bdharrison/wireless-dcc/Decoder/DCC-Decoder.png

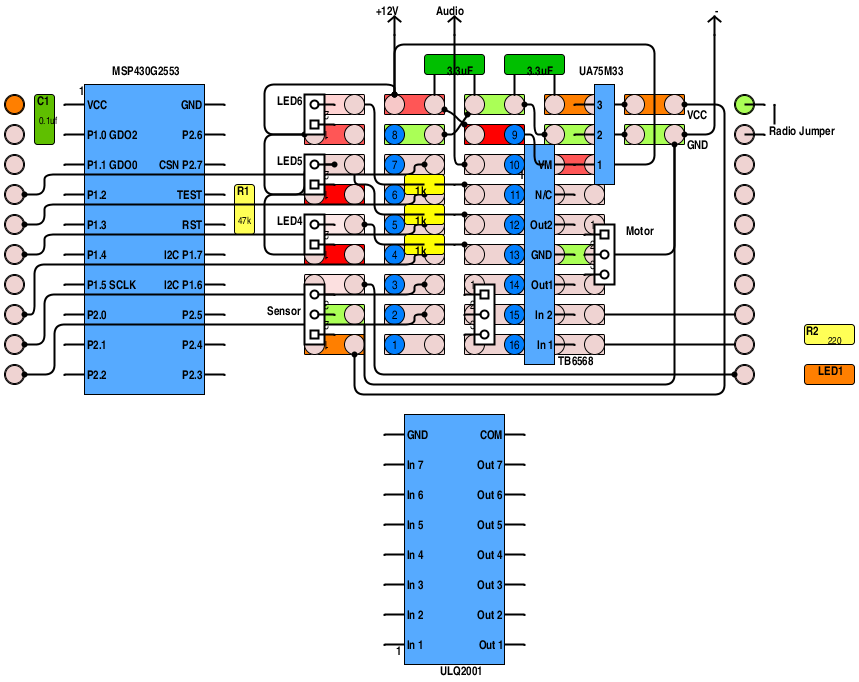
Decoder/DCC-Decoder.png
