bdharrison/wireless-dcc/Receiver/DCC-Receiver Layout.png

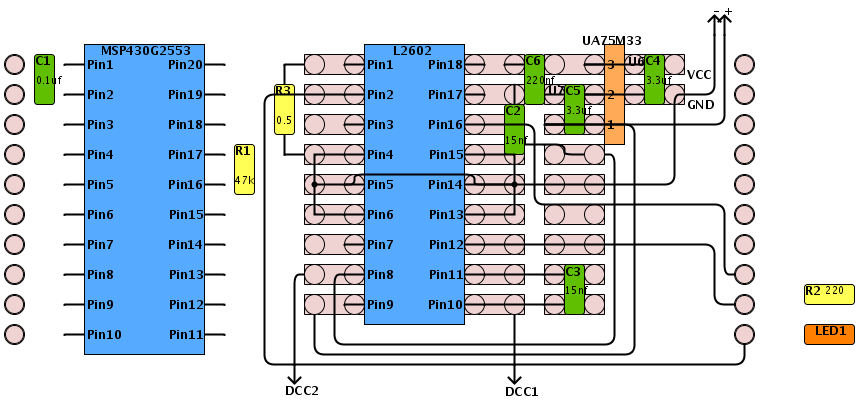
Receiver/DCC-Receiver Layout.png
