bdharrison/wireless-dcc/Receiver/DCC-Receiver Schematic.png

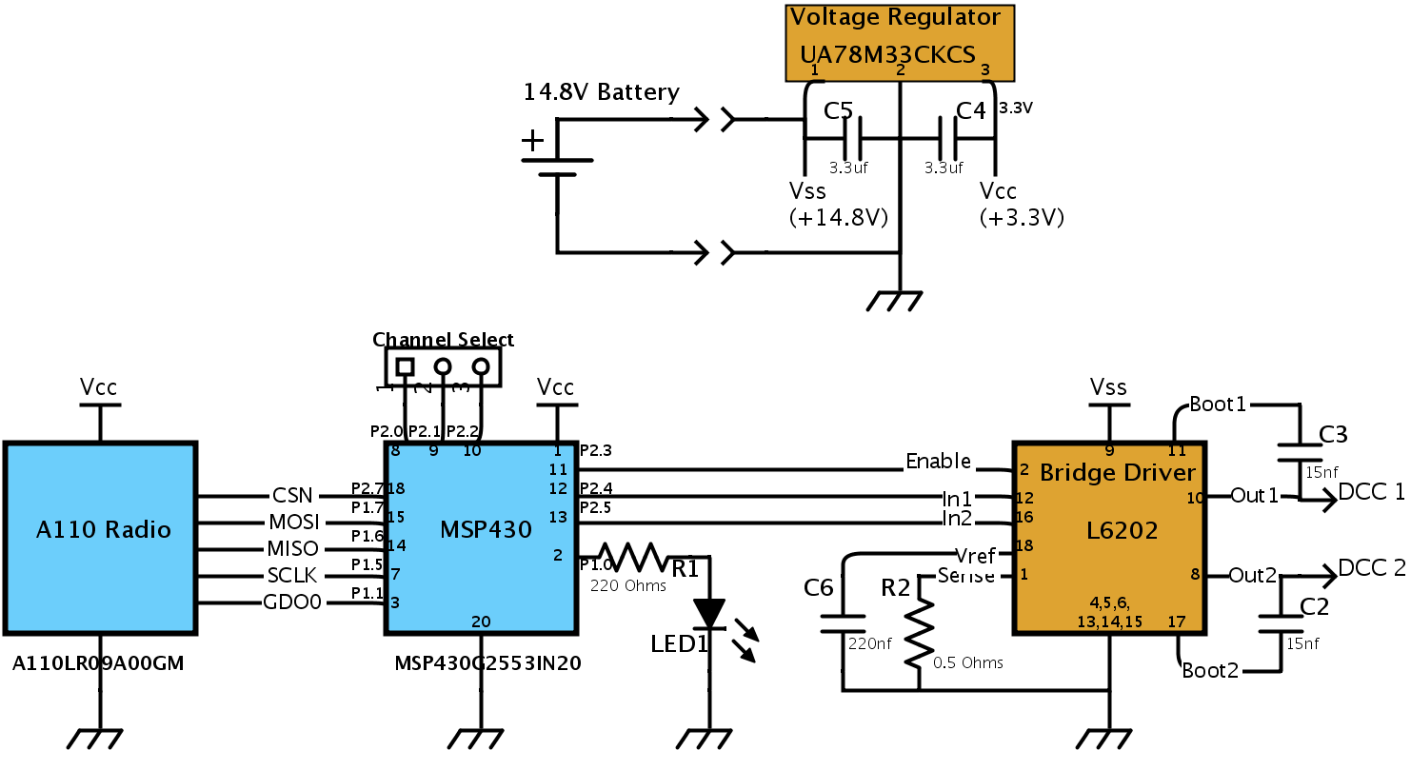
Receiver/DCC-Receiver Schematic.png
