bdharrison/wireless-dcc/Transmitter/Pushbutton Labels.png

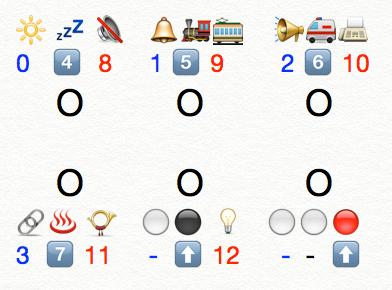
Transmitter/Pushbutton Labels.png
