bdharrison/wireless-dcc/WebController/HTML/ScreenShot.PNG

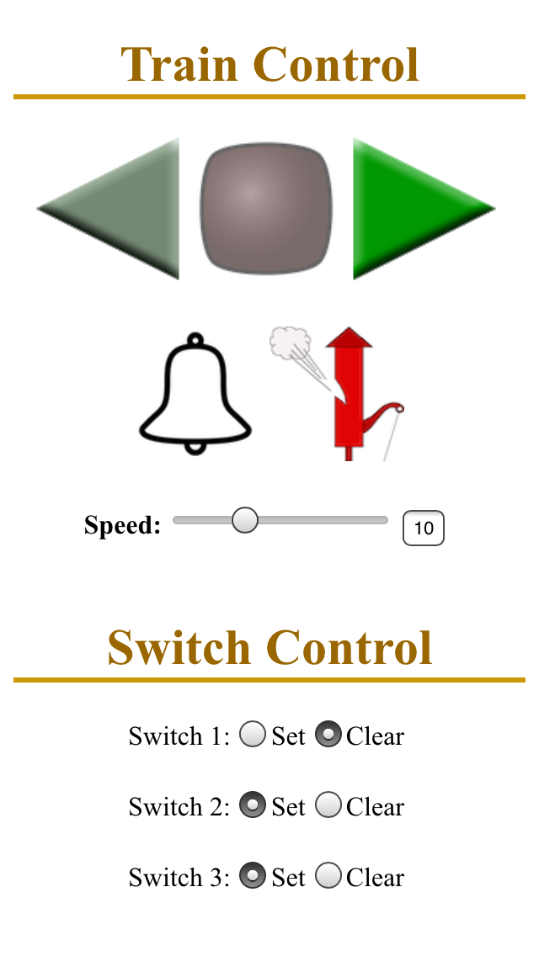
WebController/HTML/ScreenShot.PNG
