bdharrison/wireless-dcc/Receiver/DCC-Receiver Wiring.png

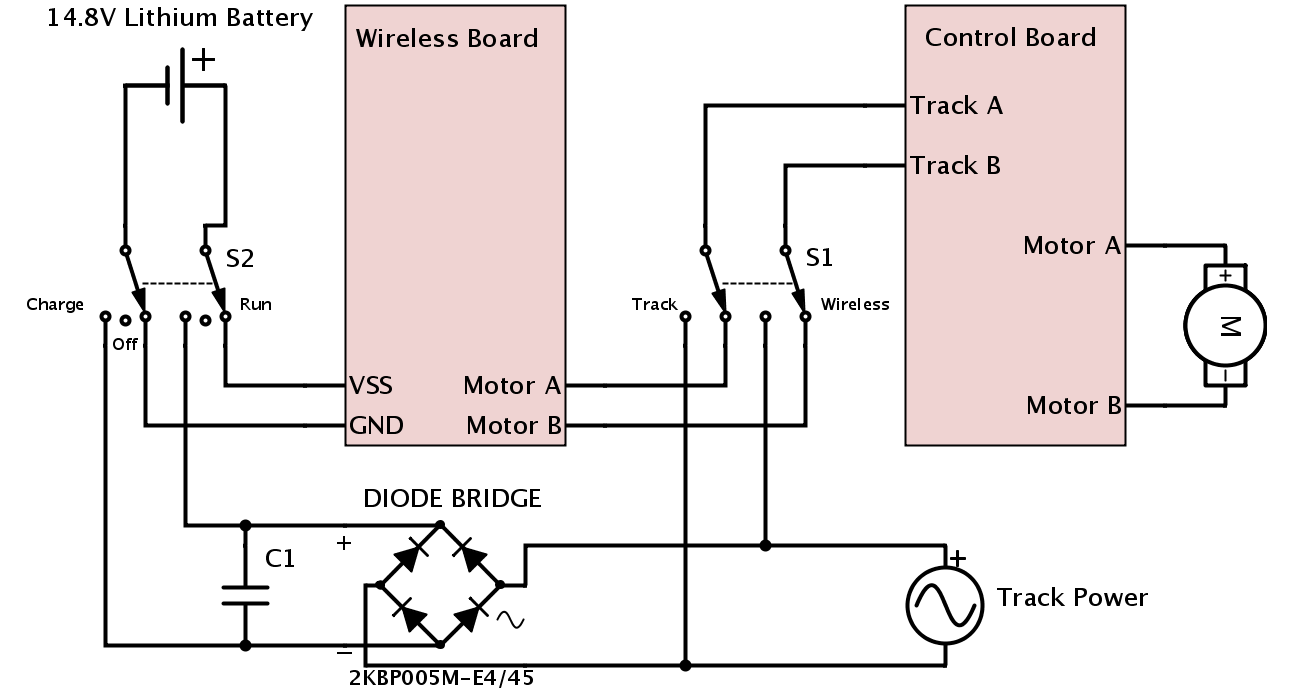
Receiver/DCC-Receiver Wiring.png
