bdharrison/wireless-dcc/(threads)

Thread 1 (2015-09-16):

issues changing channels

mdwildcat04, 2015-09-16:
built a transmitter and receiver, (actually, built them as in the GR articles, then modified them.)
these settings, they would not connect:
Tx
@1040
09 00 08 01 00 00 00 01 01 00 00 01 01 00 01 01
RX
@1040
09 00 08 04 00 01 02 FF 05 06 08 09 0C

but these settings work great.
Tx
@1040
09 00 05 01 00 00 00 01 01 00 00 01 01 00 01 01
RX
@1040
09 00 05 04 00 01 02 FF 05 06 08 09 0C

mdwildcat04, 2015-09-27:
I read the notes in the software, and realized that only 0-7 are supported.  I tried other channels and they all work, except 0.

bdharrison, 2015-11-09:
Sorry for delay in response, but I've been traveling and not monitoring this project.  Both the decoder and transmitter had a defect that didn't work with radio channel 0; now fixed by initializing 'current channel' to 0xff instead of 0.

mdwildcat04, 2016-01-26:
I noticed the change in the source files, and that the pinout changed, but the compiled hex files are unchanged.  Can I ask you to compile the new source?

bdharrison, 2016-01-30:
Sorry, forgot the hex files.  I've uploaded them now, let me know if there are any problems.

mdwildcat04, 2016-02-07:
I am still seeing the old ones on here....

bdharrison, 2016-02-08:
Can you try re-syncing?  I can see the updates as posted 10 days ago.
Decoder/Decoder.hex and Receiver/Receiver.hex.  You might need to click on
the 'branch' dropdown to force a re-sync to Master.
Cheers,
Brian.

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

mdwildcat04, 2016-02-10:
OK, I see the new hex file now.  that's weird
I have a board with this firmware on it.  the lights are working as expected, but it looks like the outputs for the bell and wisle are inverted.  I measure vdo at the pins normally, and 0 volts when the button is pressed.

mdwildcat04, 2016-02-10:
Never mind, after playing around with it some more, I went directly from the chip to the sound card, bypassing any buffer chip, and sound works as expected.

Thank you, this is working GREAT!!!!

bdharrison, 2016-02-10:
Thanks. Let me know if you've any suggestions for improvements. I'm
currently working on a version that connects to the Internet to allow
control via smartphone.
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

mdwildcat04, 2016-03-04:
will do.
What were you planning?   I had thought bout combining the radio with a Raspberry Pi and a small LCD to make a controller that allowed you to select engines, set up consists, ect with a graphical user interface.  Sadly, i cannot code my way out of a paper bag.......
Ideally, I would like to see a Wifi to air wire gateway.  something that would allow multiple users at the same time.

bdharrison, 2016-03-12:
I've created a version of the transmitter that accepts commands from a serial port.  I've coupled this with a WiFi board (a Photon from Particle.io) so that commands can be sent from the Internet.  This is essentially the WiFi to air wire gateway you wanted.  A Raspberry Pi would be a good alternative to the Photon, although the Photon provides web services that easily allow use beyond the local home network.

I've created a simple web page that can be used on a smart phone or tablet to give touch control of a locomotive and switches.  This could easily be expanded to add consist control etc.  Here's a screen shot from an iPhone.
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

benshell, 2016-03-14:
@bdharrison I've been following your work and I just wanted to say that this sounds incredible. I have a couple Photons and look forward to trying this.

bdharrison, 2016-03-23:
I've now posted the web control version of the project and welcome feedback.  The project is described at https://github.com/bdharrison/wireless-dcc/wiki/WebController

mdwildcat04, 2016-06-20:
Is there anyway to make this system work with something like JMRI?  i figured, as airwire is just wireless DCC, it should just require some additions to JMRI to recognize the air-booster half of the webcontroller part.

bdharrison, 2016-06-26:
I've not played with JMRI but this should be really to do. A JMRI system can connect to the air booster using the serial connection in this project. A JMRI adaptor could be written to interface to the serial protocol. I'll take a look when I get some time.

BTW I'm giving a short talk about this work at the National Garden Railway convention in Santa Clara, CA. Let me know if you'd like details.

mdwildcat04, 2017-02-15:
Just checking up, have you had any time to look at this?

bdharrison, 2017-04-05:
Sorry for the long delay in replying, got caught up on other things and forgot about this.
I had a quick look at JMRI and connecting to it looks quite feasible.  I really need a target project to find the time to investigate further.  Did you have a particular JMRI use case in mind?

mdwildcat04, 2017-04-05:
I want a setup were i can have multiple controllers, and have a person pick any one of them up, select a Loco from a list, and then run.  I would also like simple consisting.  I have played with JMRI, Engine driver, and DCC++ in N scale, and this setup works well for me.  I have access to android phones, and am working on a USB-OTG rotary encoder.  Something that would allow JMRI to talk to these receivers is all I am needing.

Closed 2015-11-09.

Thread 2 (2015-09-17):

issue with forward lights

mdwildcat04, 2015-09-17:
When stopped, or going in reverse, I measure ~.8 volts at pin 5.  this is causing the headlight to remain dim instead of turning off. also, in the dim state, it flickers

mdwildcat04, 2015-09-27:
after reading the notes in the software, I now understand that this is working as programmed.

Sorry about that

Closed 2015-09-27.

Thread 4 (2018-02-07):

Is it possible to add serial output from the decoder to a peripheral sound device?

jarable, 2018-02-07:
Brian - thanks again for the code. I've made a few receivers and transmitters and they all work great. I was wondering if it was possible to add a serial output from the decoder to a peripheral sound board. I've got a Raspberry Pi zero w running a Python program that gives eight channels of audio... the simplest way I can think of to control it is sending serial commands from the decoder for speed, bell, whistle... etc. I'm just not sure if the serial timing would interfere with the DCC and vice versa. I see you've got serial for the web transmitter so I'm guessing this is possible?
Sean (jarable) Lavery

bdharrison, 2018-02-18:
Hi Sean,
Glad to hear you've been finding the code useful.  I've just got back from vacation and has a quick look at the code and it does look quite possible to enable a serial interface.  I'll need to move a few things around to allow the right ports to be used.  I'll work on this in the next couple of weeks.
Cheers,
Brian.

bdharrison, 2018-04-17:
Hi Sean,
This was a little harder than I expected as there are only 2 timers to be shared between the radio, PWM motor output, UART, and a 4ms activity timer.  I've finally got something I think works, but I needed to move some ports around.  I've got the following port changes from the original decoder:
P2.0 (Pin 8): Serial TX
P2.1 (Pin 9): Serial RX
P2.2 (Pin 10): Cab light
P2.6 (Pin 19): Reverse light (No horn)

I've attached the hex output file for this version.
[SerialDecoder.txt](https://github.com/bdharrison/wireless-dcc/files/1921869/SerialDecoder.txt)

If you connect a serial device then you should receive 2 character hex codes representing the DCC command received, e.g.:
B0 60 A8 60 90 60 B0 60 A8 60 90 60 B0 60 A8 60 90 60

Let me know if this is working and does what you want.  I'll post the code if it is useful.
Cheers,
Brian.

jarable, 2018-04-18:
Thanks very much, Brian! I'll give this a shot. I picked up a couple of CC1101 transceivers from ebay and I've been trying to get them to listen to the transmitter and relay the information to an Arduino. Not much luck so far, but I'll try your code. Appreciate it.

darrelllamm0, 2020-03-19:
jarable, Sorry to be so late to the party. Your problem with the code might be that the CC1101 transceiver boards you picked up on eBay use 26MHz crystals, not the 27MHz crystals that Anaren transceiver boards use. Also, many of them do not operate well in the North American 915MHz ISM band. To operate at 26MHz you must change a number of the register settings in initSequence.  We have a GitHub project at https://github.com/martan3d/AirMiniTransmitter that provides the software for both 27MHz and 26MHz transceiver boards that might be of use. Extracted from that project (that work well for me), you might try the following initSequence if you are using 26MHz transceivers:

Receiver
const static unsigned char initSequence[] = {
       0x40,0x2E,0x2E,0x0D,0x07,0xD3,0x91,0xFF,0x04,0x32,
      0x00,0x4B,0x06,0x00,0x22,0xB7,0x55,0x8A,0x93,0x00,
      0x23, 0x3B,0x50,0x07,0x30,0x18,0x16,0x6C,0x03,0x40,
     0x91,0x87,0x6B,0xF8,0x56,0x10,0xE9,0x2A,0x00,0x1F,
     0x40,0x00,0x59,0x7F,0x3F,0x81,0x35,0x09
 };

Transmitter
const static unsigned char initSequence[] = {
        0x40,0x2E,0x2E,0x0D,0x07,0xD3,0x91,0xFF,0x04,0x32,
       0x00,0x4B,0x06,0x00,0x22,0xB7,0x55,0x8C,0x22,0x00,
       0x23,0x3B,0x50,0x07,0x30,0x18,0x16,0x6C,0x03,0x40,
       0x91,0x87,0x6B,0xF8,0x56,0x10,0xE9,0x2A,0x00,0x1F,
      0x40,0x00,0x59,0x7F,0x3F,0x81,0x35,0x09
 };

Your mileage may vary, but if you check out my http://oscaledeadrail.com pages, you might find some information of value.

Thread 5 (2019-05-05):

How do you set the channel on the receiver?

mdwildcat04, 2019-05-05:
Also, I noticed pins 8,9, and 10 are for channel select, how does that work?
It also calls for a .5 ohm resistor.  What wattage?

bdharrison, 2019-05-18:
As the receiver had some spare pins, I used the same mechanism as the original transmitter to choose a radio frequency, as described in the Garden Railways article.  Pins 8, 9 and 10 form a binary number to select the channel.  Pin 9 is an output pin set high, while 8 & 10 are input pins set low by default, thus the default channel is 010=2.  A jumper can be used between 8 & 9 to select channel 011=3.  Jump 9 & 10 to select 110=6.

mdwildcat04, 2019-05-22:
If pin nine was set to input, and jumpers used, would channels 0-7 be available?
What wattage of .5 ohm resistor is needed?

bdharrison, 2019-05-23:
Note currently you don't need to use a resistor, you can simply put a small 2-pin jumper across pins 8&9 or 9&10.

The software could be changed to allow all three pins to be used as inputs as you suggest.  You would then need to connect the pins separately to a suitable 'high', such as through a small resistor as you suggest.  The current should be very small through this resistor, so any low wattage resistor is fine.  Alternatively we could drop these input pins altogether and go back to the mechanism used in the original decoder: the software is patched for the desired channel before flashing.

Does either of these approaches meet your needs?  In practice I've never changed the channel of the receiver once I've installed it, so the software patch approach is probably the cleanest.

mdwildcat04, 2019-05-24:
The resistor I mentioned was un-related to the channel, I was referring to the one between pin 1 of the l6202 and ground.

either would work, the jumper setup would allow easier channel changes.

bdharrison, 2019-05-27:
Very little current is drawn through this resistor, so 1/8 watt is fine.

As there aren't any handy pins to use a simple 2-pin jumper, I think modifying the code to have a separate block which specifies the channel is the easiest thing to do, as described for the transmitter.  This can easily be used for all 8 channels currently supported.

mdwildcat04, 2019-10-08:
ok, i finally got one built.  I shorted 8 9 and 10 together, and it is listening on channel 7 fine.
I had thought about making a PCB that the other components can be soldered onto, and then soldered to the arden board.  with how hard it was to wire  up, this seems like an easier idea.  it would be easier to set the channel by a coded rotary switch
