bdharrison/wireless-dcc/(commit log)

2015-04-07 Added 15 minute timer and PB toggles
2015-04-11 Added support for 6 pushbuttons, F0-F12
    Moved radio channel selection to a constant and re-used P2.0-2 as
    additional pushbuttons. Buttons 4 & 5 act as ‘shift’ buttons to access
    F4-7 and F8-12 respectively.
2015-04-17 Added programming of loco address & radio channel
    Added program ability. Hold down PB5 when pressing PB0 to wake from
    sleep. Then use PBs to enter 2 digits for radio channel followed by 3
    digits for loco address. [0-3: PB0-3; 4-7: PB4+PB0-3; 8-9:PB5+PB0-1]
    Note: hold down PB4 & PB5 during programming to reset to defaults.
    [main.c]
2015-04-17 Tidy up LED flashing
2015-05-11 DCC Decoder Project
    Wireless receiver and DCC decoder, directly drives DC motor and 7
    outputs.
2015-05-12 Added optional extra output as alternative to sensor input
2015-05-14 Fix up power off mode
    [main.c]
2015-05-15 Fixes to auto operation
    [main.c]
2015-11-09 Support radio channel 0
    Fix initialization so that radio channel 0 works correctly
    [main.c]
2016-03-23 New WebController Project
    WebController includes a transmitter that accepts commands over the
    serial port, plus software for a Photon board from Particle to connect
    this to the web. An example HTML file is also provided.
2016-03-27 Corrected the accessory address encoding
    [main.c]
2016-09-22 Separate reverse switch added
    Option to replace center-off pot with a full range pot and separate
    reverse switch on P1-4 (PUSH6).
    [main.c]
